costeacorina/Project-1---Electronic-Devices-and-Circuits/Proiect Docs/P1_2023_434E_Costea_Corina_GSD_N7_OrCad.pdf

## Universitatea Națională de Științe și Tehnologie POLITEHNICA BUCUREȘTI

Facultatea de Electronică, Telecomunicații și Tehnologia Informației

## Proiect 1 - Dispozitive și circuite electronice

## Generator de semnal dreptunghiular

Student: Costea Corina
Grupa: 434E-MON
Coordonator: Conf. Dr. Ing. Florin Drăghici 2023-2024

## Cuprins

## 1.Tema proiectului

Tema 6 - Oscilator semnal dreptunghiular (N = 7)

Să se proiecteze și realizeze un oscilator semnal dreptunghiular cu următoarele caracteristici:

- Frecvența de oscilație, fo, reglabilă în intervalul: 7 ÷ 21 [KHz];
- Factor de umplere: 0.5;
- Sarcina la ieșire, RL: 7 [KΩ];
- Valoarea (vârf la vârf) a oscilației la ieșire, Vo, reglabilă în intervalul: 0 ÷ 1.4 [V];
- Semnalul la ieșire nu are componentă continuă;
- Domeniul temperaturilor de funcționare: 0⁰
- 70⁰C (verificabil prin testare în temperatură);
- Semnalizarea prezenței tensiunilor de alimentare cu diodă de tip LED.

Circuitul va fi proiectat și realizat sub forma unui modul electronic a cărui structură de interconectare va fi concepută în:

Tehnologie SMT & PCB.

## 2.Schema bloc

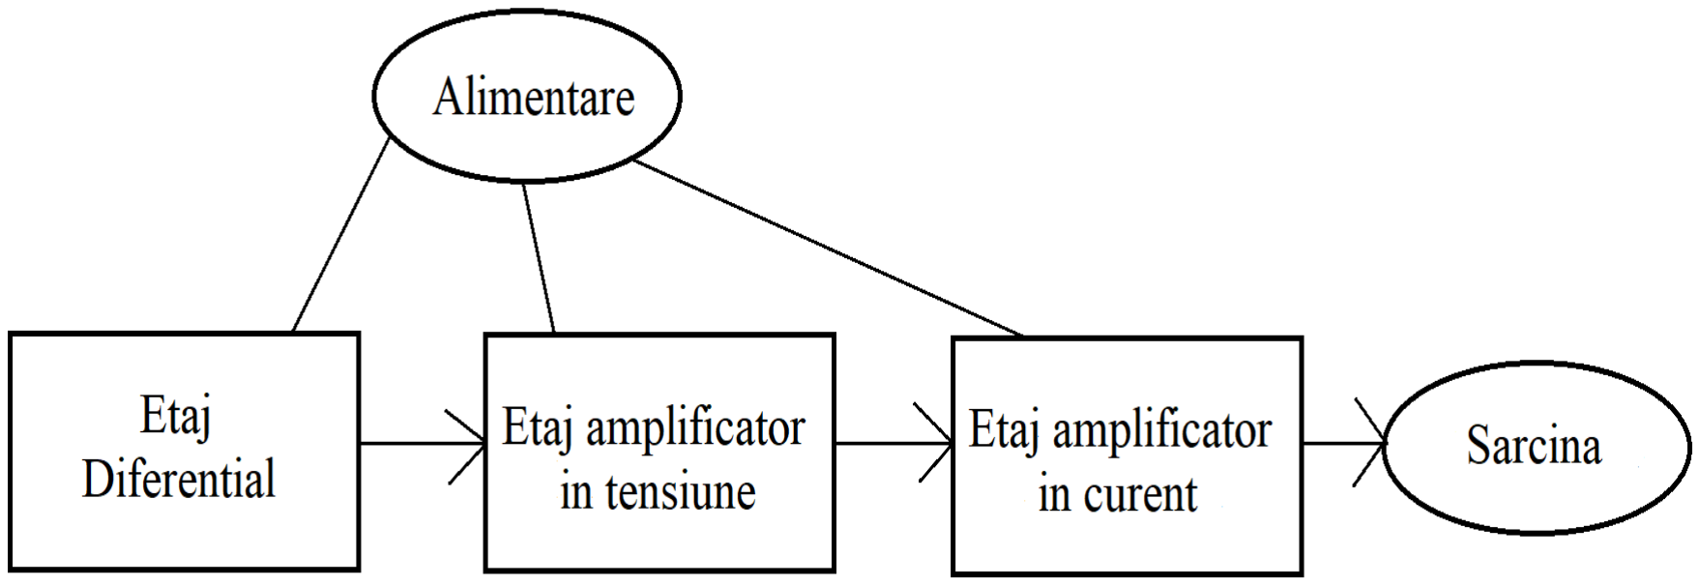
[picture p10: figure]

### Oscilator de relaxare

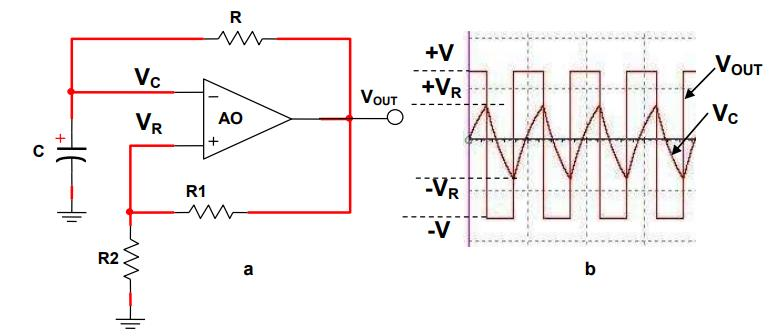
[picture p11: figure]

Pentru a realiza un generator de semnal dreptunghiular am folosit un Oscilator de relaxare a cărui funcționare se bazează pe încărcarea și descărcarea unui condensator.
Tensiunea de pe condensatorul C se aplică pe intrarea inversoare a amplificatorului operaţional AO. Intrarea neinversoare este conectată la divizorul de tensiune format din rezistenţele R1 şi R2 prin intermediul căruia se aplică o parte din semnalul de ieşire a AO. La aplicarea tensiunii de alimentare condensatorul C este descărcat deci intrarea inversoare a AO se află la potenţial 0. La ieşirea AO apare nivelul maxim pozitiv (+V) iar condensatorul C începe să se încarce prin intermediul rezistorului R. Când tensiunea pe condensator este egală cu tensiunea de reacţie de la intrarea neinversoare (+VR), intrarea neinversoare se află la potenţial maxim (+VR). La ieşirea AO apare nivelul maxim negative (-V) iar condensatorul C începe să se descarce de la valoarea +VR la valoarea –VR. Când tensiunea pe intrarea inversoare atinge valoarea –VR, AO comută la nivelul maxim pozitiv (+V) şi ciclul se reia.
Astfel la ieşirea amplificatorului operaţional apare o tensiune de formă dreptunghiulară. Prin calcule (se regăsesc la capitolul Calcule Analitice), am determinat tensiunea de referință VR la care semnalul comută.

VR =(R2/R1+R2) * V

## 3.Schema electrică

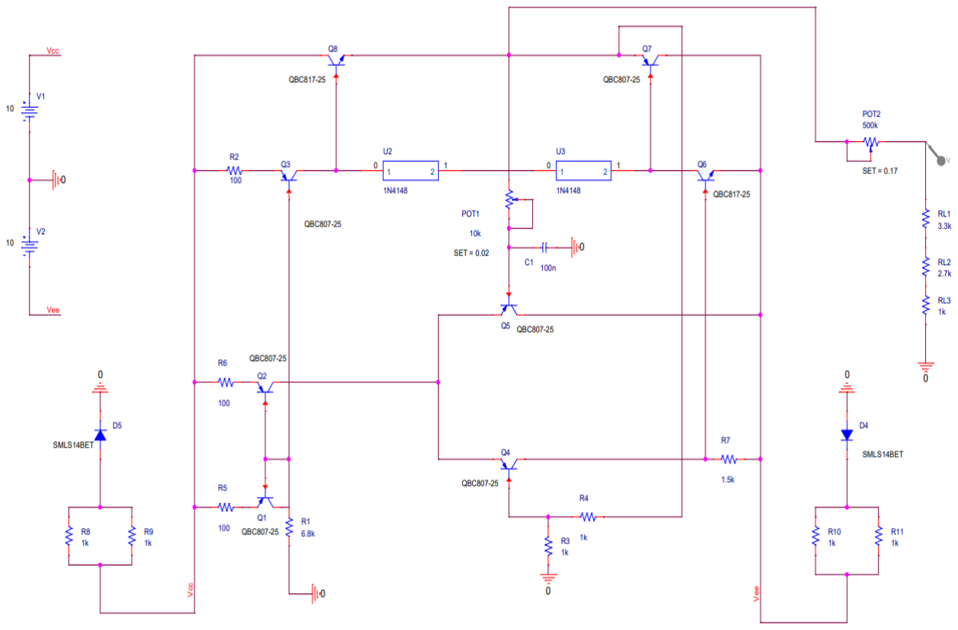
[picture p12: figure]

## 4. Componența circuitului

### 4.1 Sursa de alimentare

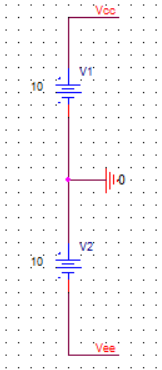
[picture p13: figure]

Am ales o alimentare simetrică de ±10 V cu o ramură de +10V și o ramură de -10V, aceasta fiind o valoare des întâlnită.

### 4.2 Oglinda de curent

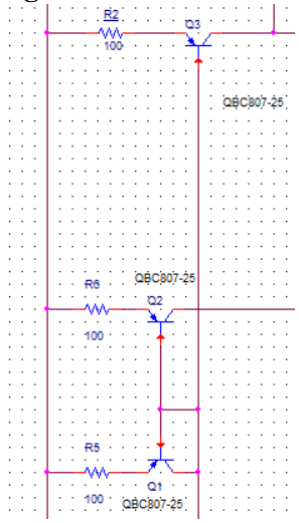
[picture p14: figure]

Oglinda de current este cea mai răspândită sursă de current. Aceasta este compusă din trei tranzistori identici (Q1, Q2, Q3) și trei rezistoare (R1, R2, R3) cu valoarea rezistenței de 100 de ohmi. Aceste rezistențe se numesc rezistențe de degenerare si au valori egale pentru a ajuta să se copieze curentul de referință în mod egal prin celelalte două tranzistoare.
Am ales tranzistoarele Q1, Q2, Q3 PNP de tipul QBC807-25 deoarece au un factor de amplificare în curent foarte mare, hFE=400 ceea ce ajută la o egalitate mai bună între curentul de referință și curentul de ieșire din oglindă, dar și pentru a elimina cat mai mult variația cu temperatura.

### 4.3 Etajul diferențial

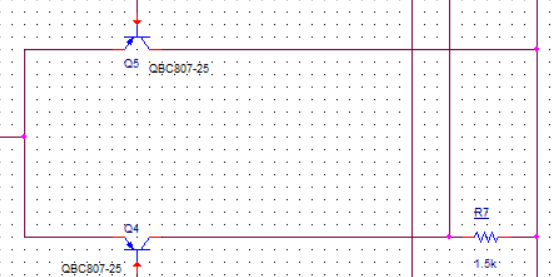
[picture p15: figure]

Etajul diferențial are rolul de a realiza adaptarea de impedanță între sursa de semnal și următorul etaj. Acesta transformă un semnal de tip tensiune într-un semnal de tip curent, deci este un etaj de tip transconductanță.
Etajul diferențial este alcătuit din tranzistoarele Q4 și Q5, tranzistoare identice de tipul QBC807-25, dar este conectat în același timp și la oglinda de curent prezentată anterior pentru stabilitate și pentru a reduce zgomotul.
Curentul care intră în etajul diferențial provine de la Q2 care face parte din oglinda de curent. Acest curent nu se împarte în mod egal pe cele două ramuri ale etajului diferențial deoarece rezistența R7 absoarbe mai mult curent pe care îl împinge spre următorul etaj format din tranzistorul Q6.
Q6 este un etaj ce are rolul de a transforma curentul primit de la etajul anterior într-o tensiune pe care în același timp o și amplifică fiind un etaj în configurație emitor comun.

### 4.4 Etajul de ieșire

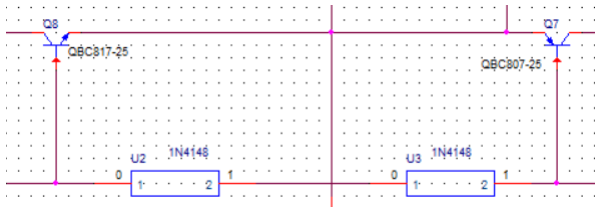
[picture p16: figure]

Etajul de ieșire este alcătuit din două tranzistoare complementare, de tip colector comun Q7 și Q8 de tipul QBC807-25, respectiv QBC817-25, legate într-o configurație push-pull. Deoarece între bazele tranzistoarelor există o cădere de tensiune data de tensiunea de pe cele două diode, acest etaj de ieșire este unul de clasă AB caracterizat de distorsiuni medii și randament mediu.Deoarece întreg circuitul nu prezintă distorsiuni atât de ridicate, pot opta și pentru un etaj de ieșire în clasă B, asta însemnând sa scurtcircuitez cele două diode.

### 4.5 LED-ul

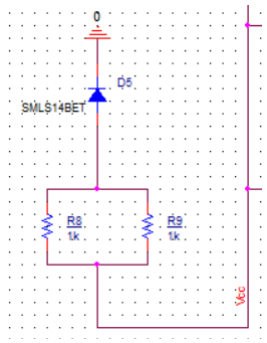
[picture p17: figure]

LED-ul a fost introdus pentru a semnaliza alimentarea circuitului. Am înseriat ledul cu o grupare paralel de rezistoare astfel încât pe acesta să cadă o tensiune de aproximativ 3V.
În acelși timp, rezistentele au și rolul de protecție pentru diodele tip led.

## 5.Relațiile de dimensionare

## 5.1. Factorul de umplere

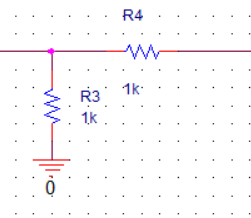
[picture p18: figure]

Factorul de umplere este determinat de divizorul rezistiv R6 –> R5 si acesta este egal cu R3/(R3 + R4).
Avand in vedere ca factorul de umplere | trebuie sa fie 0.5, se aleg R3 = R4.
Am ales | R3 = R4.= 1k deoarece din simulări am realizat faptul că această valoare este cea
mai potrivită pentru intervalul meu de frecvențe, [7kHz ; 21kHz]. Dacă dorim să lucrăm la frecvențe mai mari, alegem o valoare mai mare pentru cele doua rezistențe.

### 5.2. Frecvența de oscilație

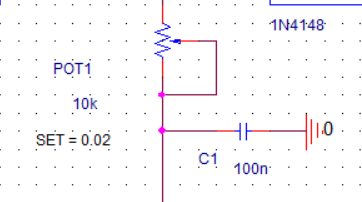
[picture p19: figure]

Frecventa de oscilatie este determinata de reteaua RC formata din P1= 10k si C și trebuie să aparțină intervalului [7kHz ; 21kHz].
Pentru a calcula frecvența de oscilație, calculăm perioada folosind formula specifică pentru oscilatorul de relaxare, și anume:
T = 2*R*C*ln[(1 + R3/(R3 + R4))/(1 - R3/(R3 + R4))]
R3/(R3 + R4) = 0.5 => T = 2* Re * C

Valoarea capacității condensatorului C este C = 100 nF.
Rezistența R poate fi reglată cu ajutorul potențiometrului POT1 = 10k.

Pentru a obține cele două valori ale frecvenței de oscilație, setăm potențiometrul 1 la cele doua valori(0.071 pentru 7kHz, respective 0.02 pentru 21kHz) calculate la Capitolul 6 “Calcul Analitic”.

### 5.3. Amplitudinea vârf-la-vârf

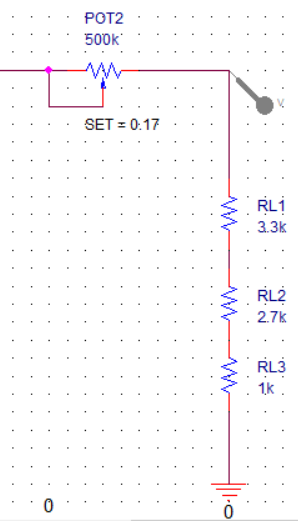
[picture p20: figure]

Amplitudinea varf-la-varf este determinata Capitolul 6 “Calcul Analitic”.

### 6. Calculul analitic

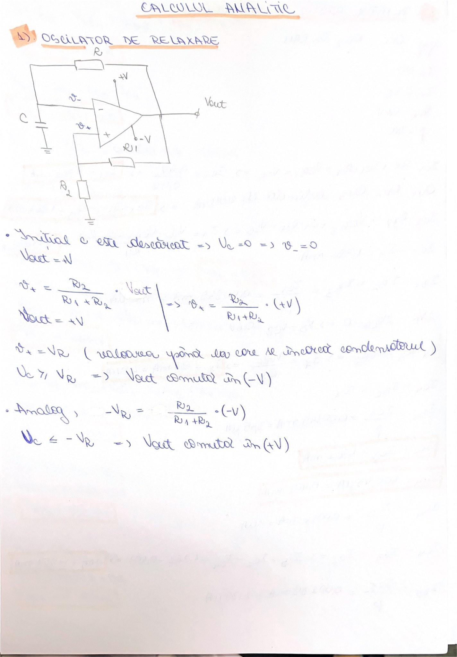
[picture p21: page 12]
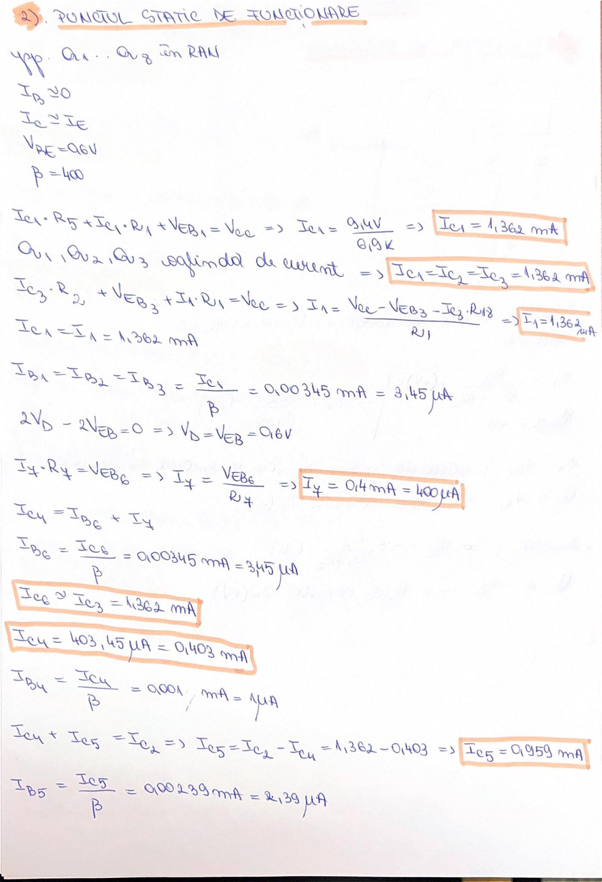
[picture p22: page 13]
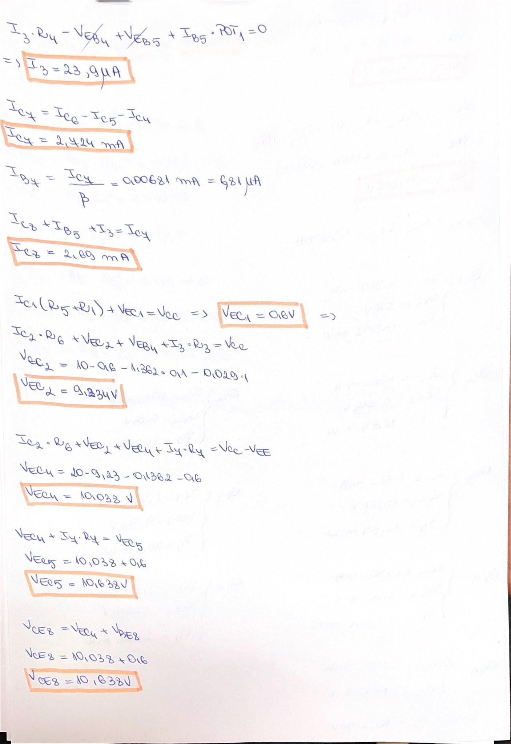
[picture p23: page 14]
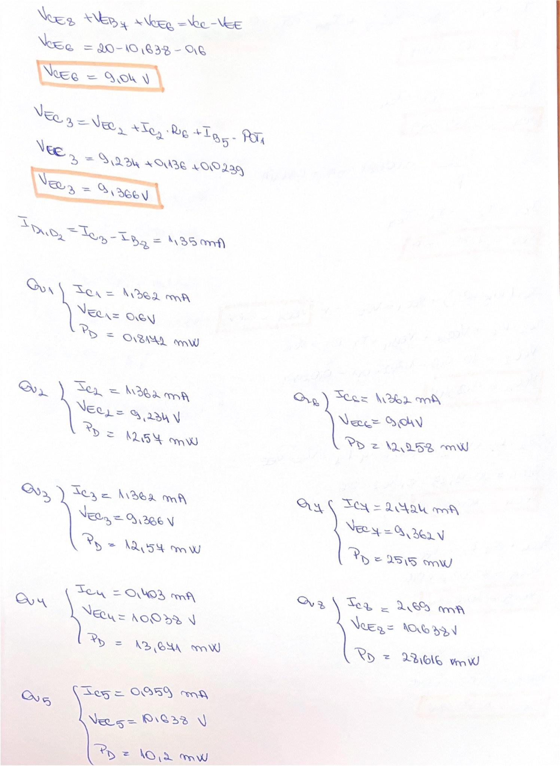
[picture p24: page 15]
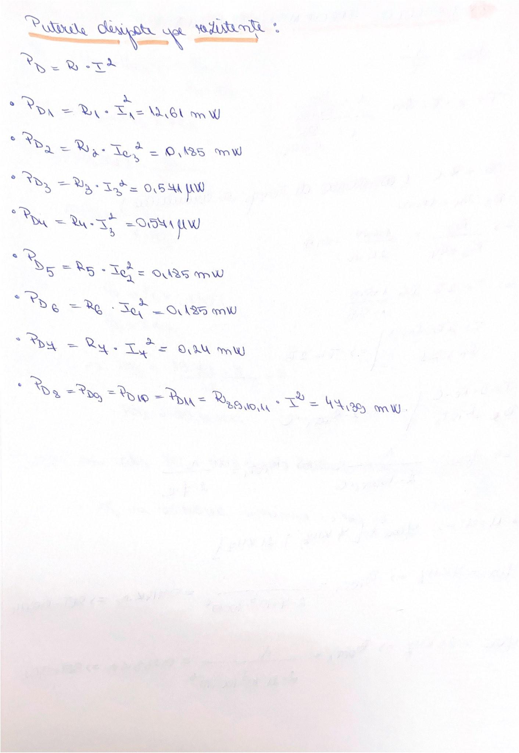
[picture p25: page 16]
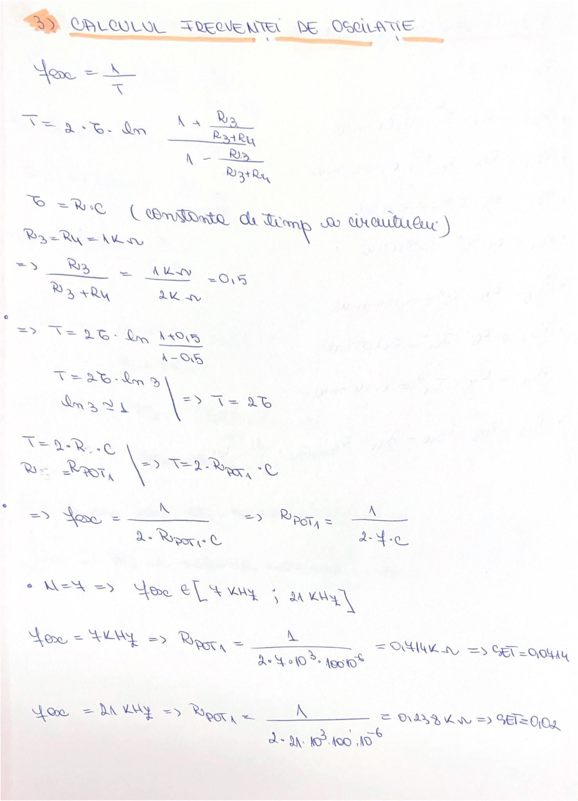
[picture p26: page 17]

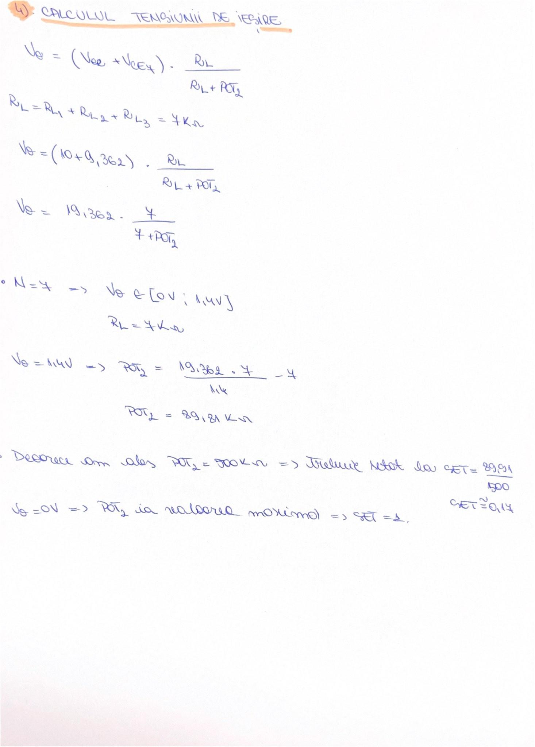
[picture p27: figure]
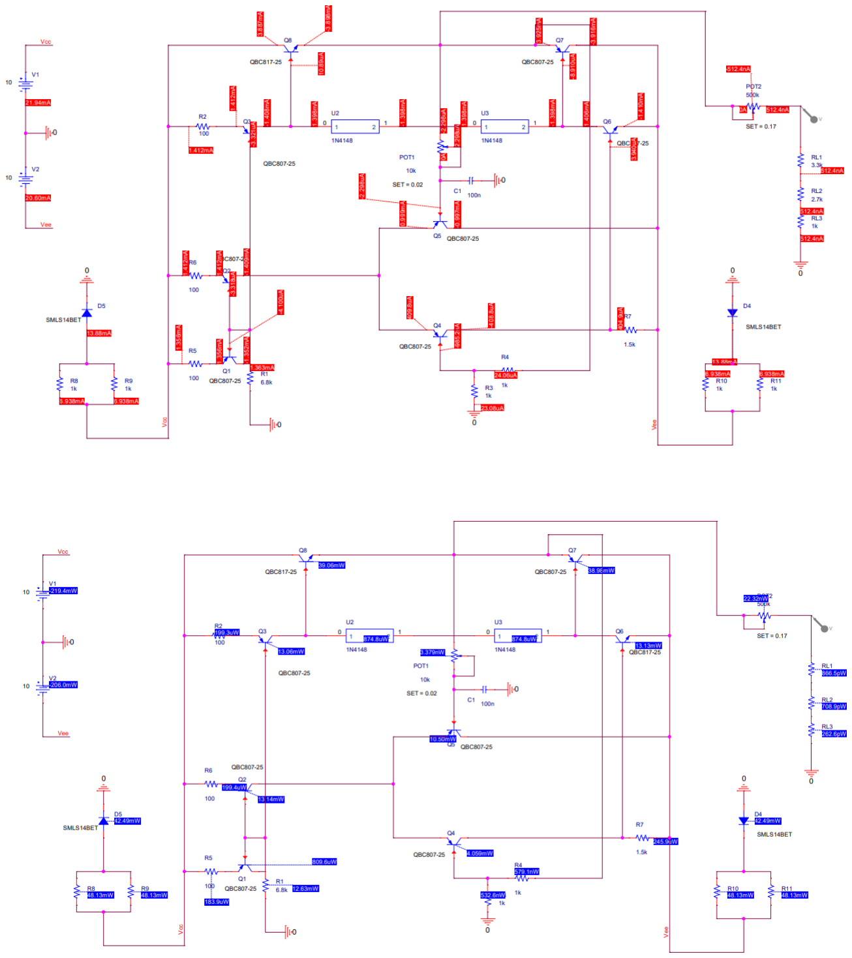
[picture p28: page 19]

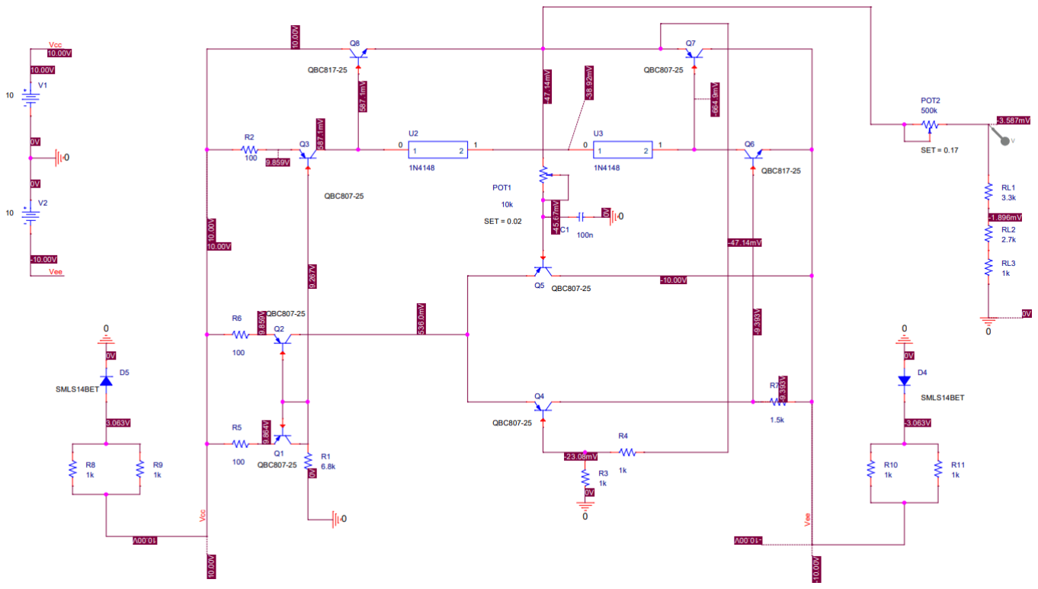
[picture p29: figure]

### 7. Schema cu conectori

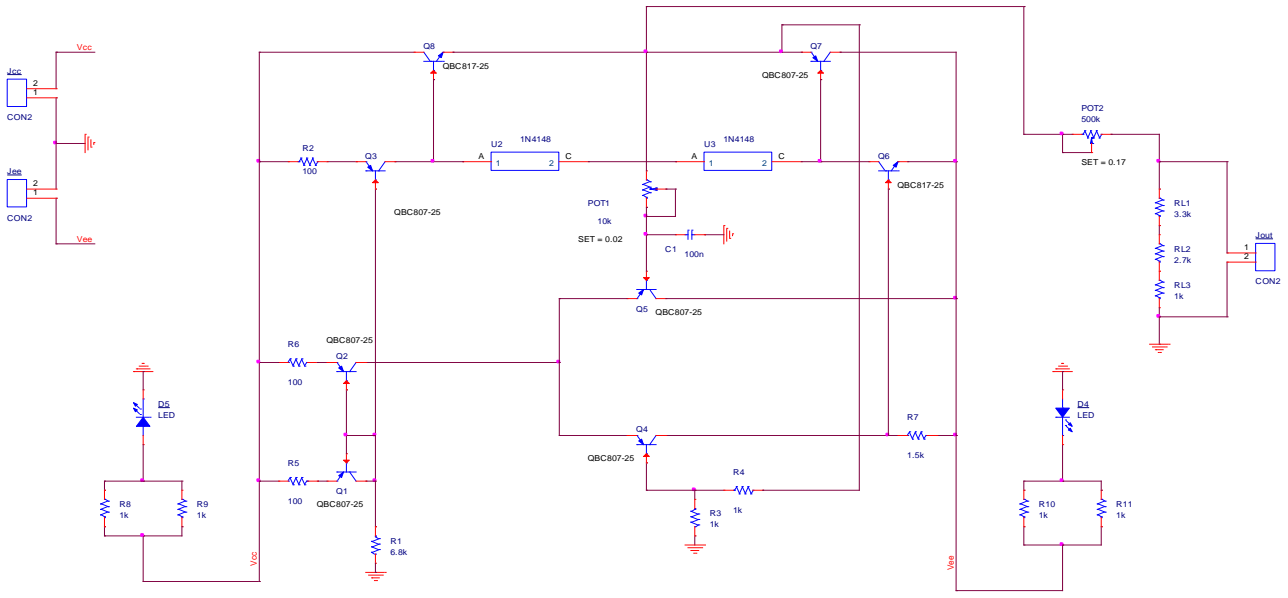
[picture p30: figure]
POT1; SET = 0.02; D5 LED; QBC817-25; VeeVcc; QBC807-25; Vcc; Jee; CON2; Q5 QBC807-25; POT2 500k; SET = 0.17; D4 LED; Jout; Vee; QBC807-25 R5; Jcc

Pentru a realiza partea de PCB, am modificat schema proiectului, punând în locul surselor de tensiune, dar si la ieșire conectori.
Fiecărei componente din circuit i-am atribuit cate un footprint după cum urmeaza: la condensator SMC0805, la rezistoare SMR0805, la diode si leduri SMD0805, la tranzistoare TO236, la potentiometre TS53YL si la conectori SMR2512.
Proiectul PCB va fi realizat folosind straturile electrice TOP și BOTTOM, plasând toate componentele pe stratul TOP. Placa va fi una pătrată cu dimensiunile de 40X40 mm.
Spațierea în toate cazurile este de 14 mils, iar lungimile traseelor sunt de 20 mils în cazul traseelor de alimentare, respectiv de 16 mils in restul cazurilor. Conexiunea cu masa am realizat-o printr-un plan de masă pe stratul electric TOP.

Bill of Materials
1 | 1 | C1 | 100n
2 | 2 | D4,D5 LED
3 | 3 | Jout,Jee,Jcc | CON2
4 | 1 | POT1 10k
5 | 1 | POT2 500k
6 | 6 | Q1,Q2,Q3,Q4,Q5,Q7 QBC807-25
7 | 2 | Q6,Q8 QBC817-25
8 | 1 | RL1 | 3.3k
9 | 1 | RL2 | 2.7k
10 | 7 | RL3,R3,R4,R8,R9,R10,R11 1k
11 | 1 | R1 | 6.8k
12 | 3 | R2,R5,R6 | 100
13 | 1 | R7 | 1.5k
14 | 2 | U2,U3 1N4148

### 8. Layout

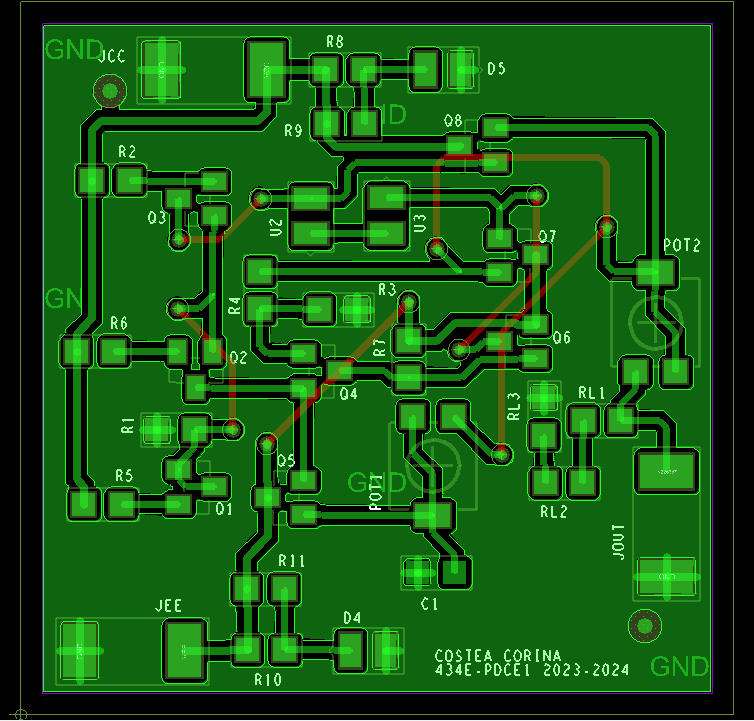
[picture p31: figure]

### TOP

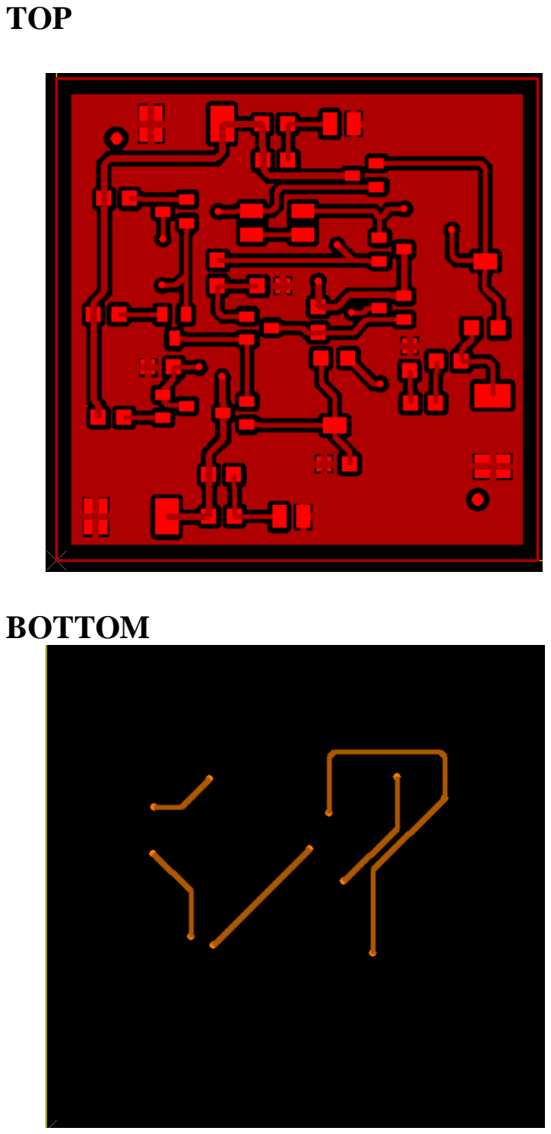
[picture p32: page 23]

### BOTTOM

## SSTOP

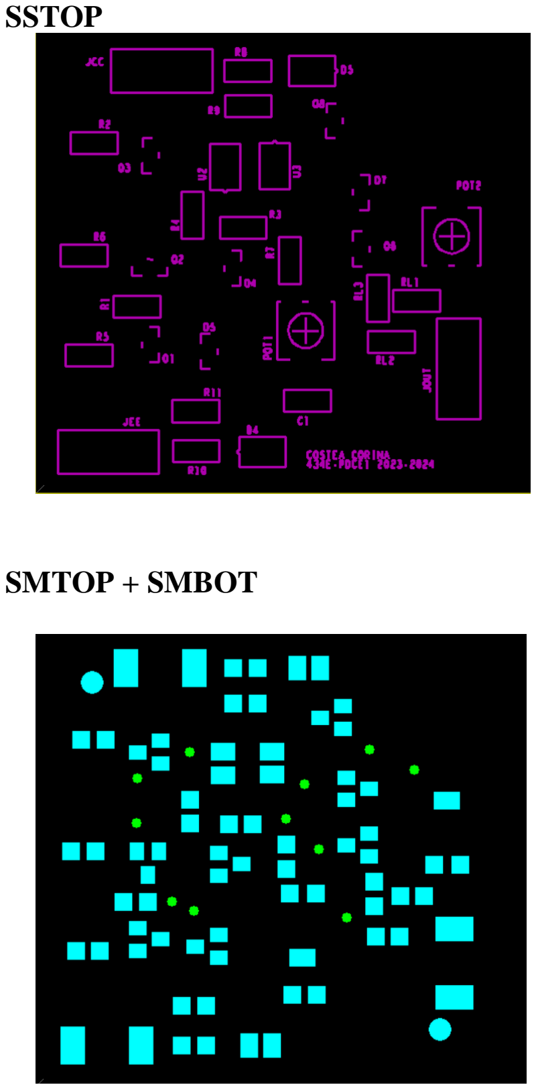
[picture p33: page 24]

### SMTOP + SMBOT

### SPTOP

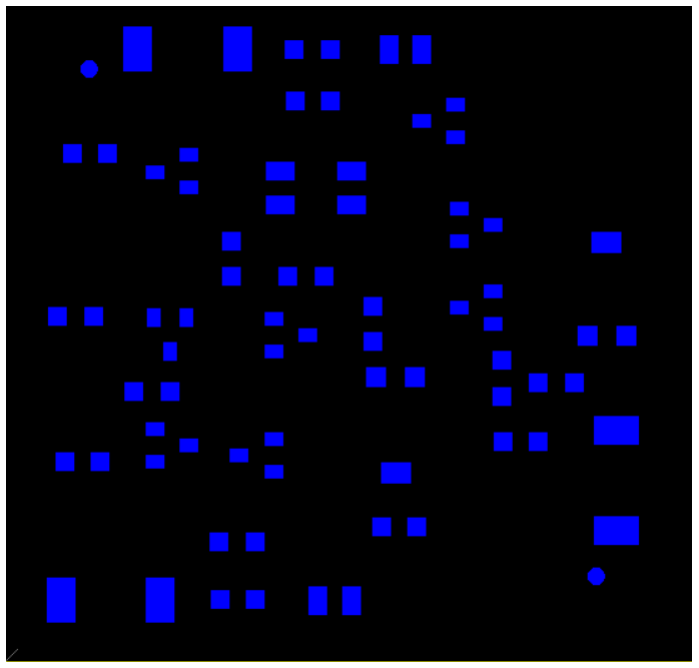
[picture p34: figure]

### BO+FAB

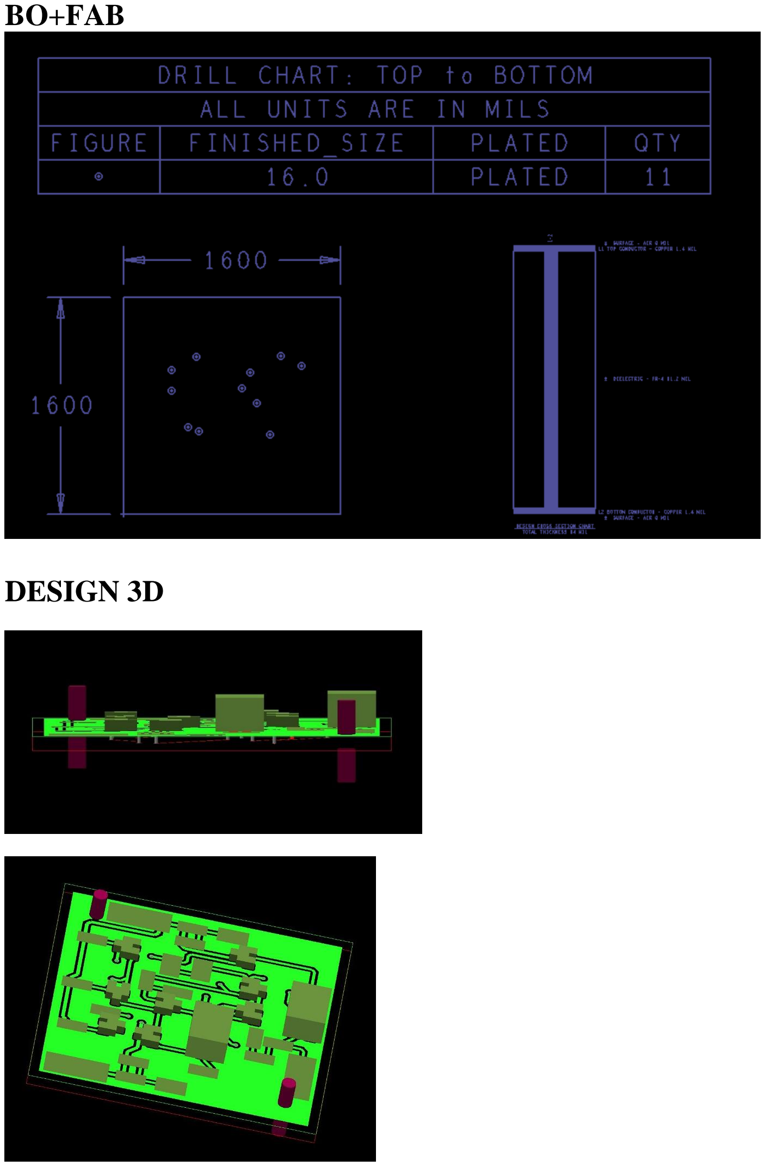
[picture p35: page 26]

### DESIGN 3D

## 9. Instructiuni de utilizare

Proiectul realizat conține schema unui generator de semnal dreptunghiular, pornind de la un oscilator de relaxare.
Acesta a fost realizat cu scopul de a obține la ieșire un semnal dreptunghiular căruia îi poate fi modificată frecvența, dar si tensiunea de iesire. Acestea două se pot modifica cu ajutorul a două potentiometre, POT1 și POT2, în funcție de dorințele utilizatorului. În cazul meu, frecvența circuitului a fost setată în intervalui [7;21]kHz (cu ajutorul POT1), iar tensiunea de ieșire [0;1,4]V (cu ajutorul POT2).
Funcționalitatea circuitului a fost testată de asemenea în temperatură, între -20 și 120 de grade.
Tensiunea de ieșire se măsoară între conectorul Jout si GND.
- Pentru o tensiune Vout = 1.4 V => valoarea lui POT2 de 89.81kΩ, deci SET = 0.17
- Pentru o tensiune Vout ~= 0 V => valoarea lui POT2 este maxima, deci SET = 1
