costeacorina/Project-1---Electronic-Devices-and-Circuits/Simulations/7kHz_0V.png

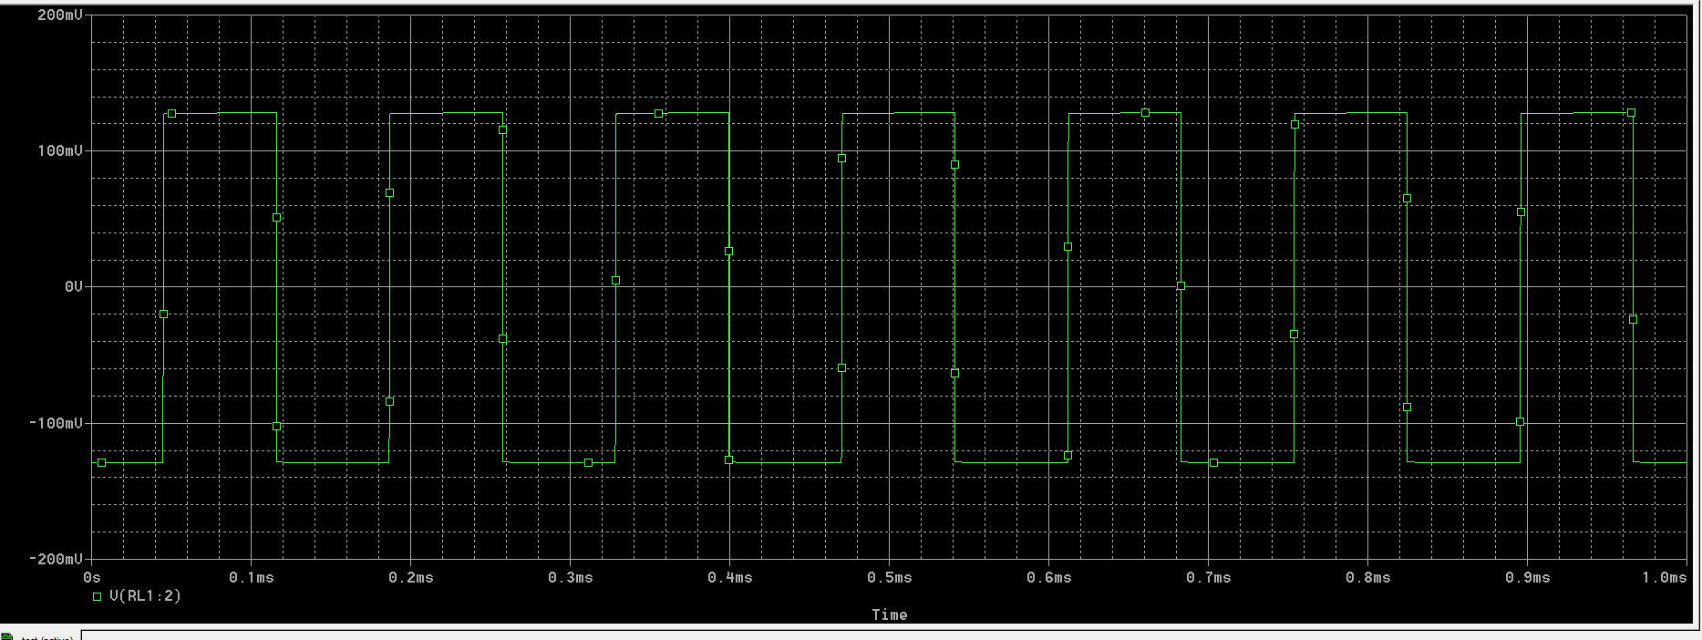
Simulations/7kHz_0V.png
