costeacorina/Project-1---Electronic-Devices-and-Circuits/Simulations/7kHz_0V_temp_0_25_70.png

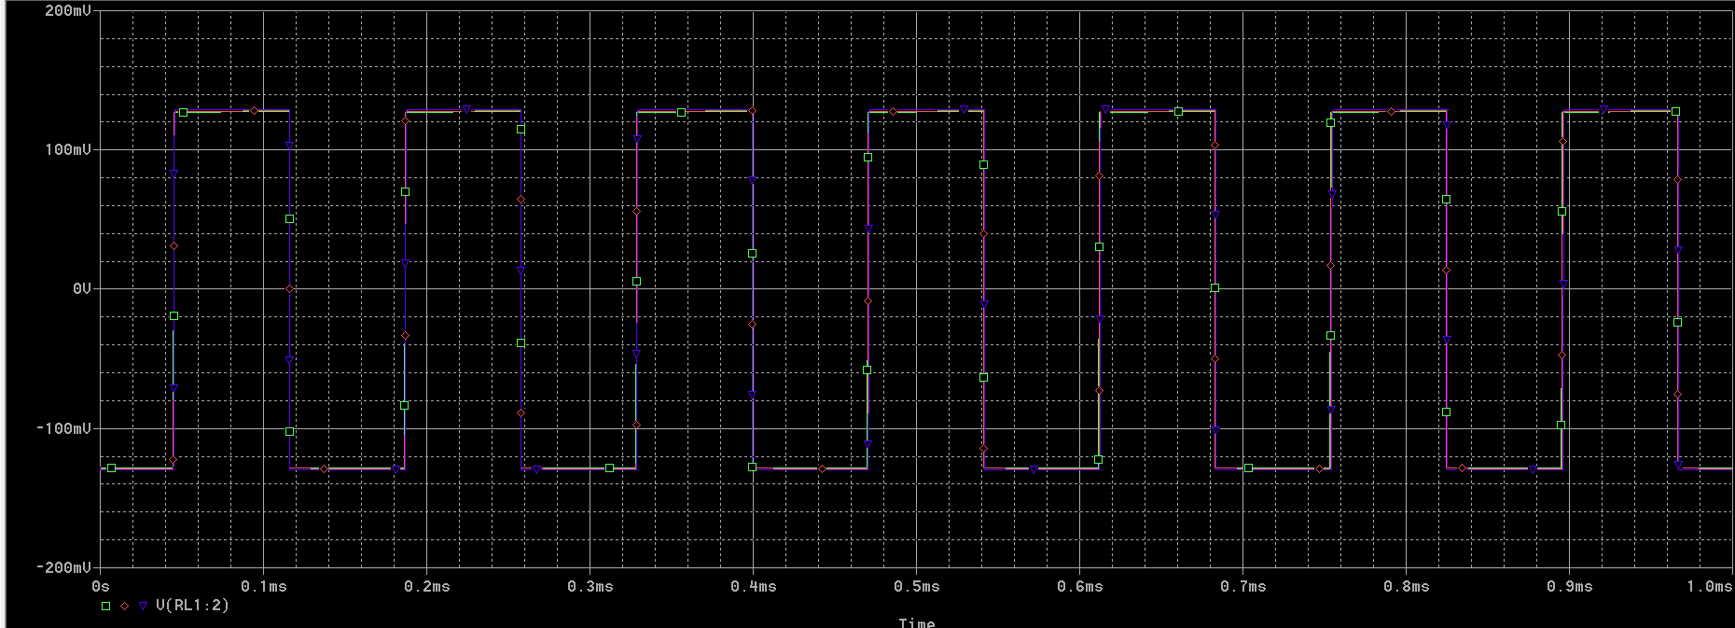
Simulations/7kHz_0V_temp_0_25_70.png
