costeacorina/Project-1---Electronic-Devices-and-Circuits/Simulations/7kHz_0V_temp_-20_0_120.png

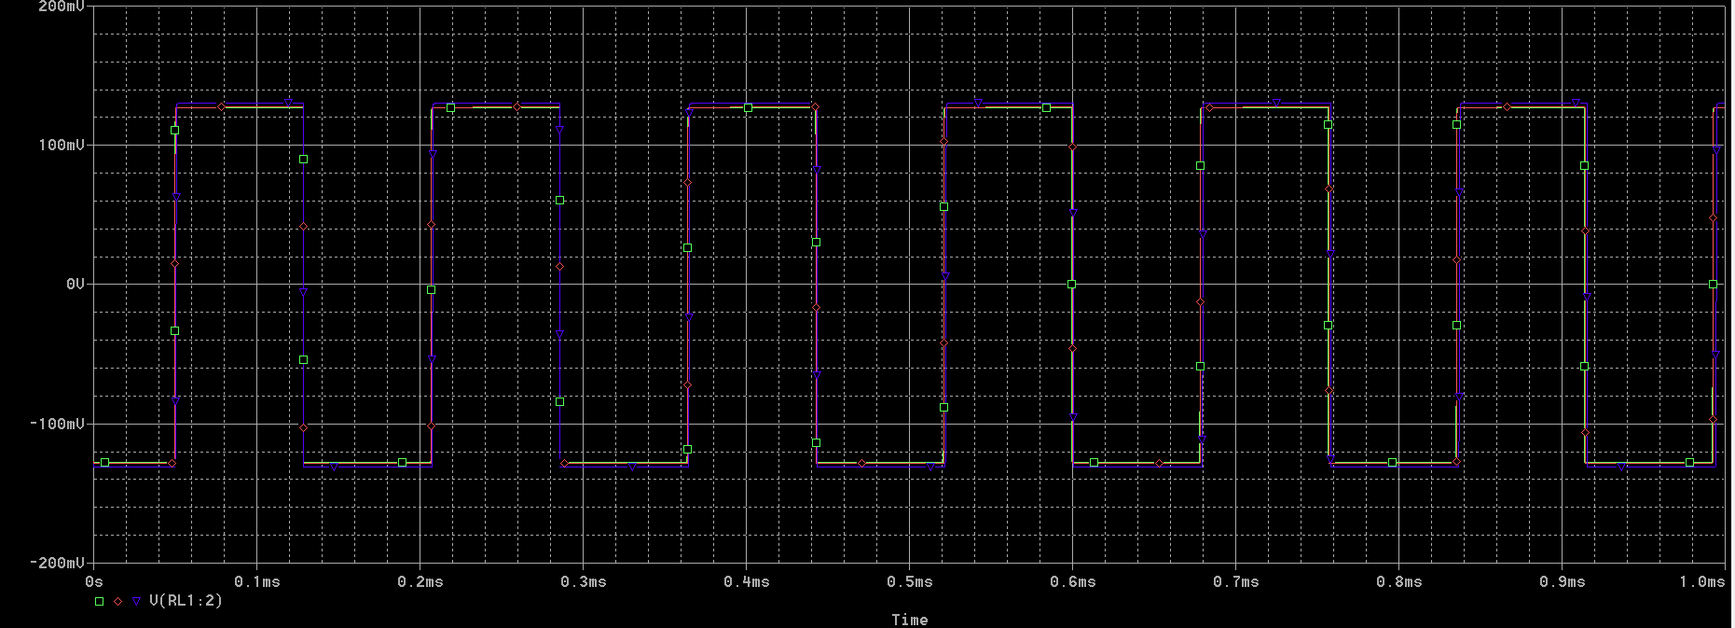
Simulations/7kHz_0V_temp_-20_0_120.png
