costeacorina/Project-1---Electronic-Devices-and-Circuits/Simulations/7kHz_1.4V.png

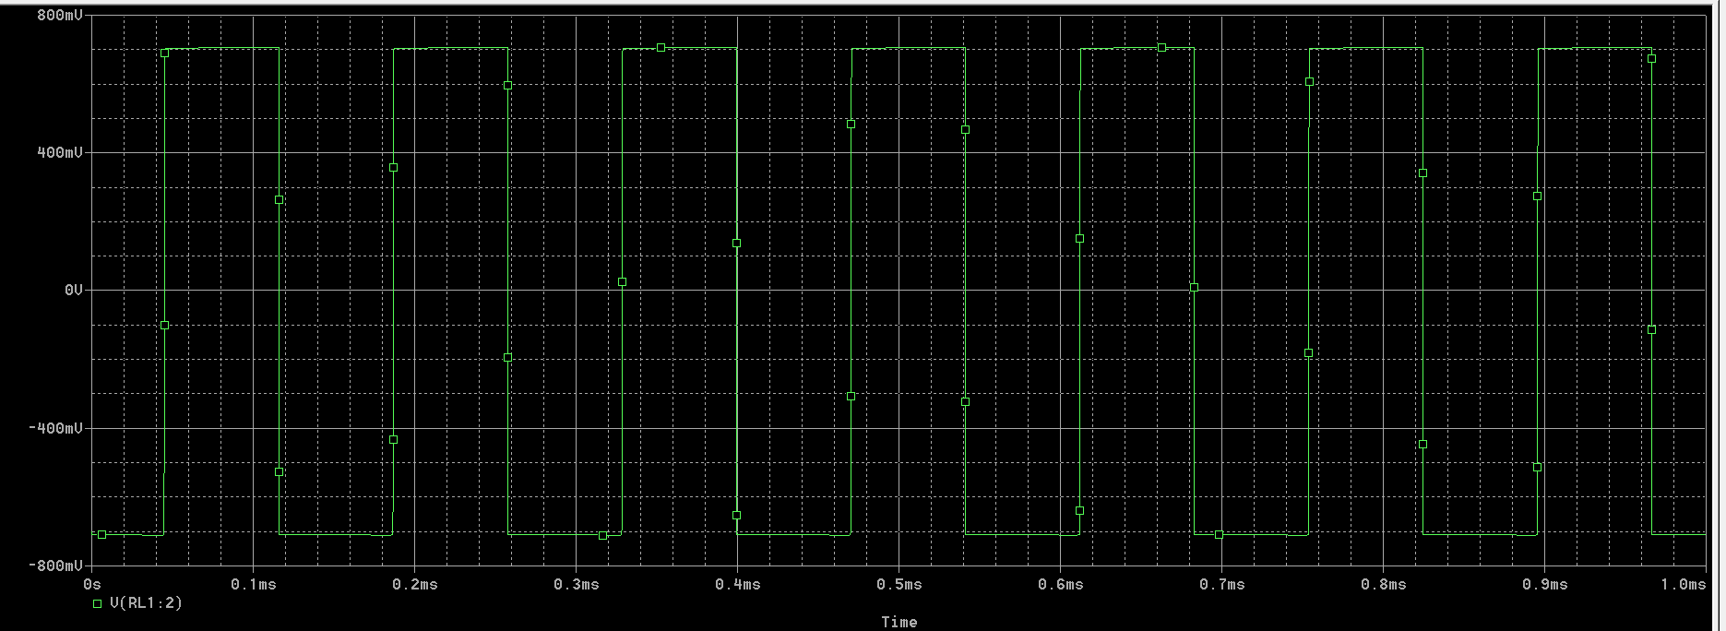
Simulations/7kHz_1.4V.png
