costeacorina/Project-1---Electronic-Devices-and-Circuits/Simulations/21kHz_0V.png

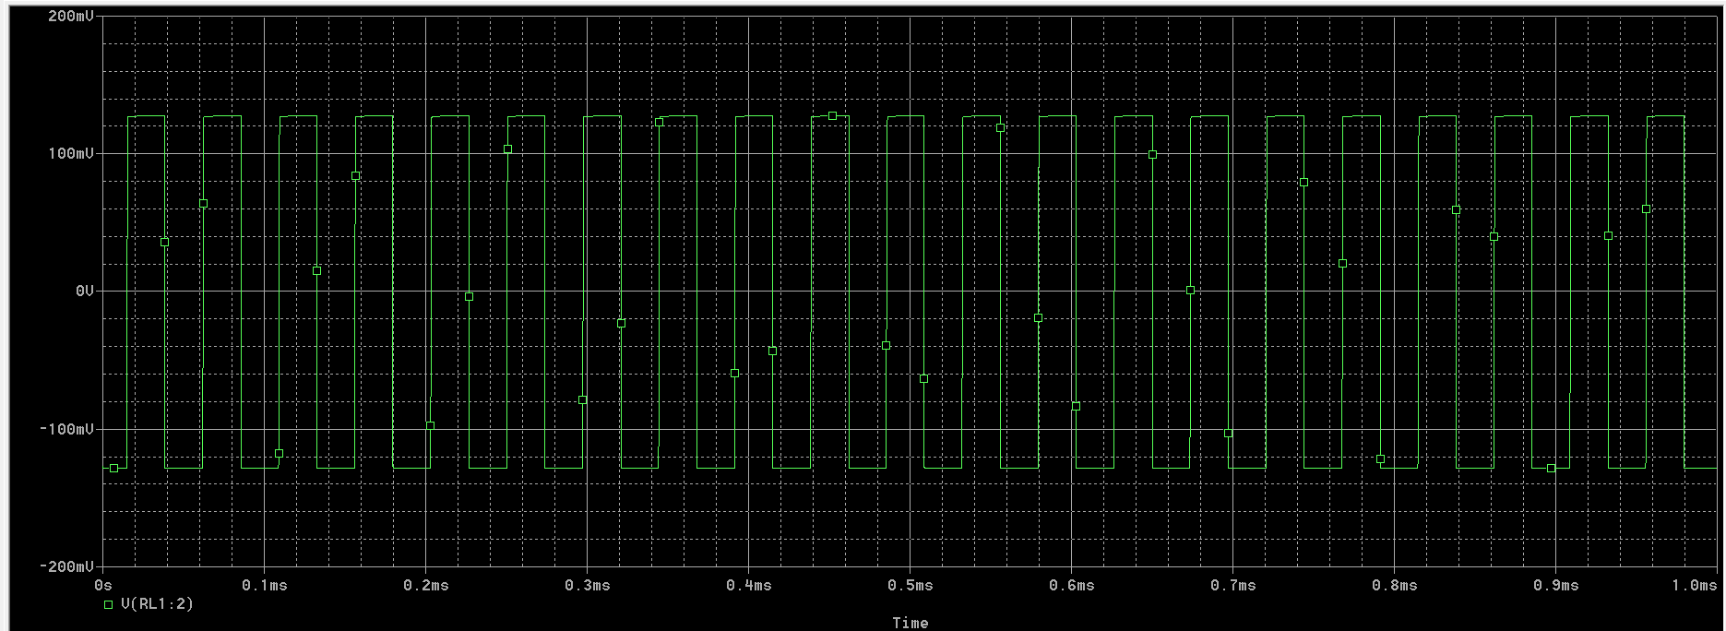
Simulations/21kHz_0V.png
