costeacorina/Project-1---Electronic-Devices-and-Circuits/Simulations/21kHz_1.4V.png

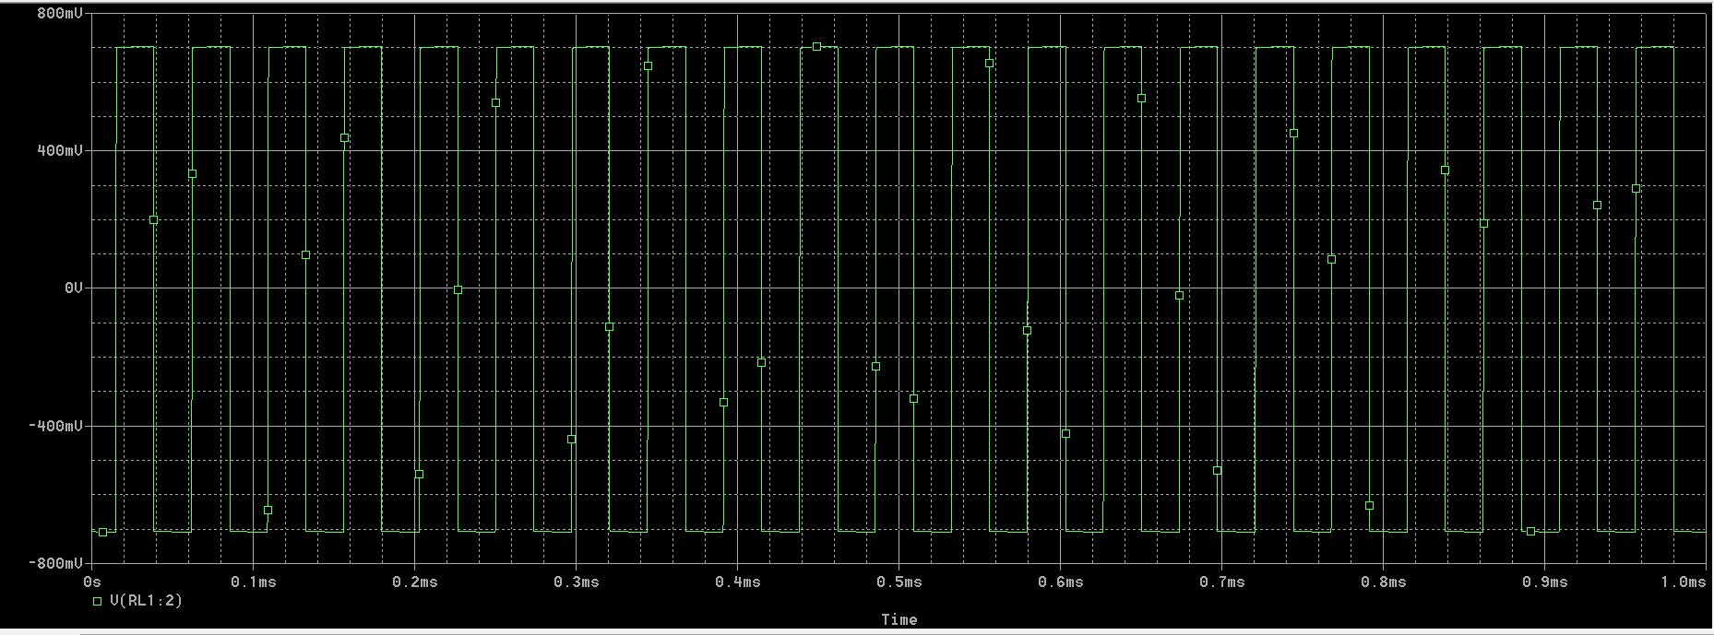
Simulations/21kHz_1.4V.png
