costeacorina/Project-1---Electronic-Devices-and-Circuits/Simulations/21kHz_1.4V_temp_-20_0_120.png

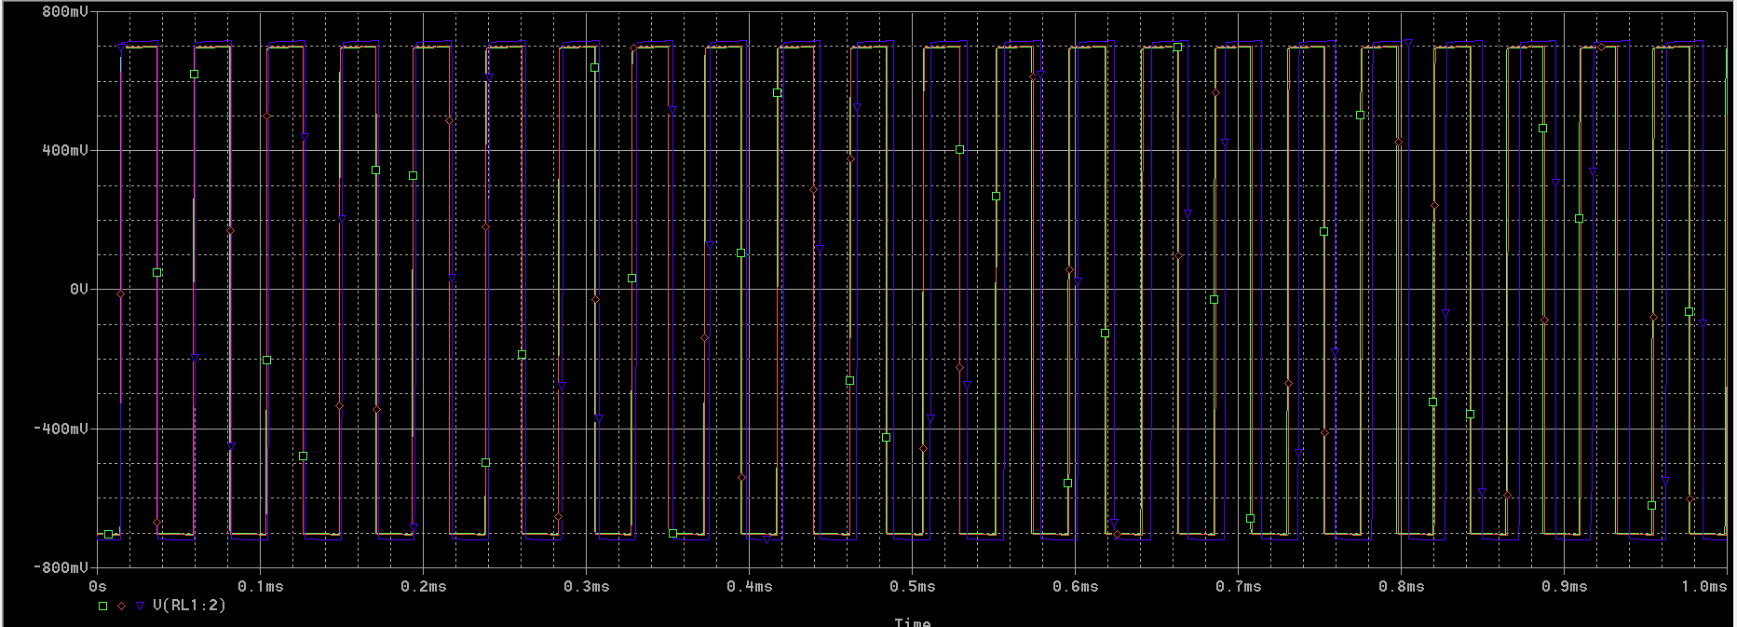
Simulations/21kHz_1.4V_temp_-20_0_120.png
