costeacorina/Project-1---Electronic-Devices-and-Circuits/Simulations/curenti.png

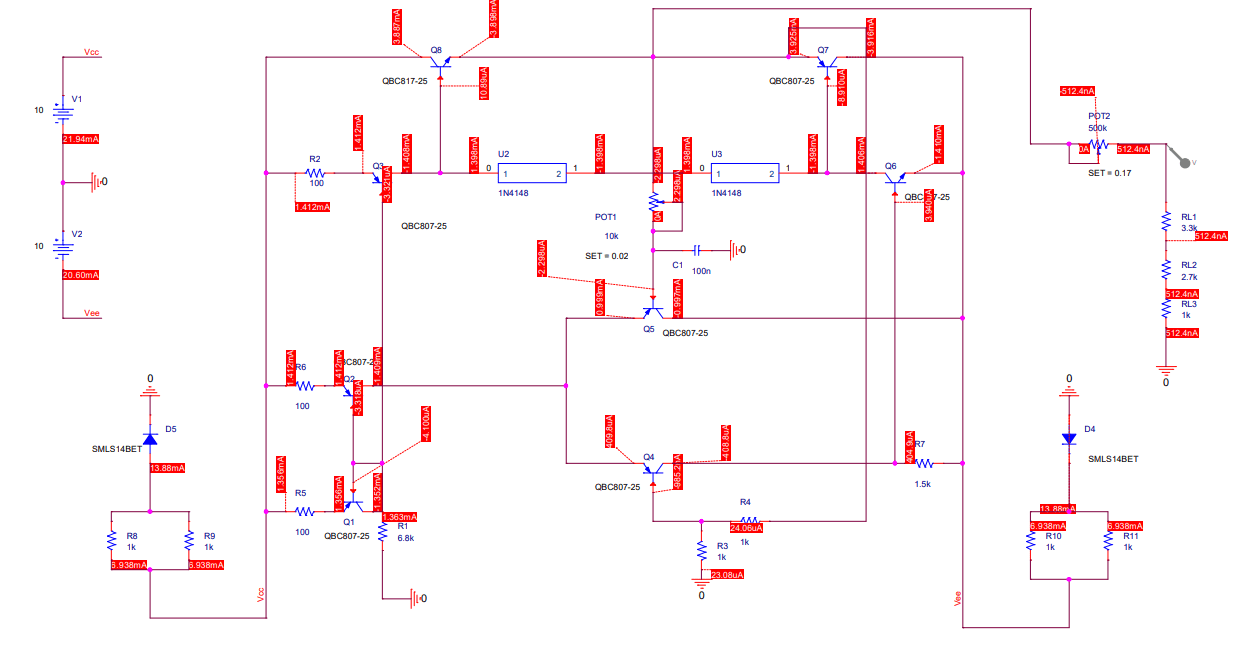
Simulations/curenti.png
