costeacorina/Project-1---Electronic-Devices-and-Circuits/Simulations/puteri.png

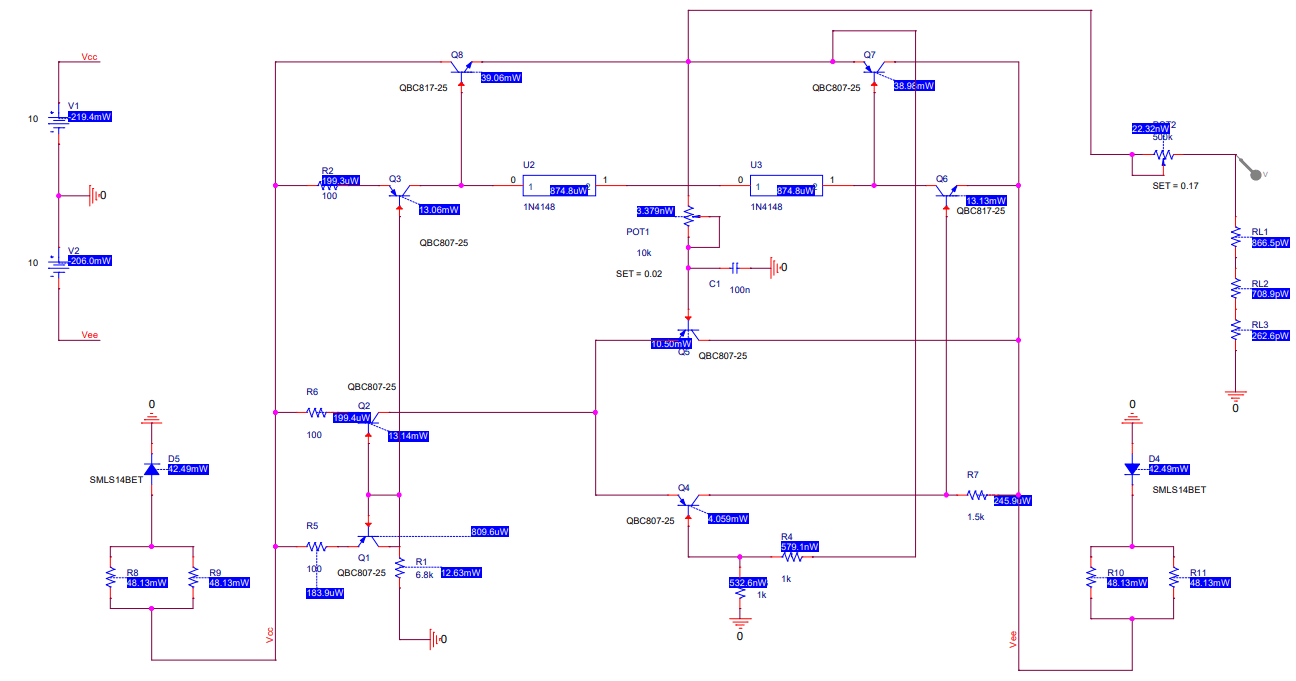
Simulations/puteri.png
