costeacorina/Project-1---Electronic-Devices-and-Circuits/Simulations/tensiuni.png

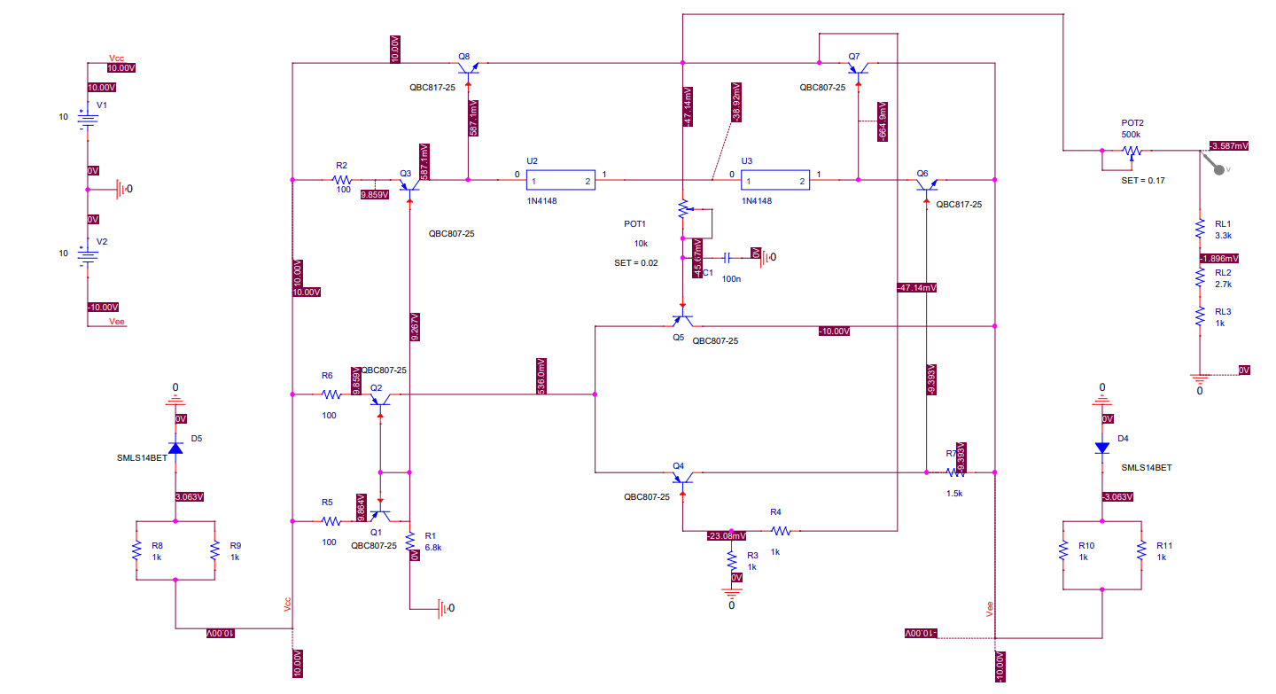
Simulations/tensiuni.png
