costeacorina/Project-1---Electronic-Devices-and-Circuits/(list of files, drawings)

Other design files:
Schematics/Generator semnal dreptunghiular/DREPT.DSN
Schematics/Generator semnal dreptunghiular/drept.opj
Schematics/Schema layout/LY.DSN
Schematics/Schema layout/ly.opj
